YajwinGrover/Stepper-Motor-Driver/(commit log)

2026-07-29 Enhance README with detailed project overview
    Expanded project description and technical details about the stepper motor driver, including H-bridge functionality, transistor usage, and control methods.
2026-07-29 Added schematic photos
2026-07-29 Include schematic images in README
    Added images of schematics for dual H-bridges and full driver to README.
2026-07-29 Fix code file references in README
    Updated references to code files for motor control implementations in the README.
2026-07-30 Enhance debugging output for phase lookup values
    Added debugging print statements for phase A and B values.
